slowcorners/Minimal-UART-CPU-Dev/(list of files, drawings)

Other design files:
KiCAD/Minimal UART CPU 512K SSD/8-Bit CPU 32k.dsn
KiCAD/Minimal UART CPU FLASH Edition/8-Bit CPU 32k.dsn
