slowcorners/Minimal-UART-CPU-Dev/(notices)

Notices in the files:
KiCAD/Minimal UART CPU FLASH Edition/RegA.sch:
creativecommons.org/licenses/by-nc-sa/3.0/deed.en
License: CC BY-NC-SA 3.0
